sahilag22/COURSE-PROJECT-CE738A-/ppt-GROUP3_22103052,22103049.pptx

PROJECT -2
Hydrometry: CE-738A
SOIL MOISTURE
2022-2023
DEPARTMENT OF CIVIL ENGINEER
HYDRAULICS AND WATER RESOURCES ENGINEERING
Course Instructor: Presented by:
Dr. Shivam Tripathi Sahil Agrawal and Ranjan Kumar
Monday, November 14, 2022

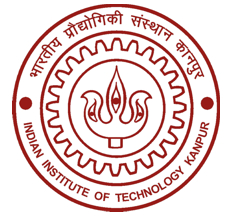
[picture p1: figure]
See the source image

## TABLE OF CONTENTS

1. INTRODUCTION
2. VARIOUS SENSOR TO MEASURE SM
3. LISTS OF COMPONENTS
4. CIRCUIT DIAGRAM
5. SEQUENCE OF PROCESSES
6. UNCERTAINTY ANALYSIS
7. LIMITATIONS
8. REFERENCES

## 1. INTRODUCTION

- Soil moisture represents the water content present in the soil
- It is a key variable in controlling the exchange of water and heat energy between the land surface and the atmosphere through transpiration and evaporation.
- Monitoring soil moisture helps to detect the health of the plant.
- Can be measured by direct and indirect methods.
- Direct methods includes: gravimetric and volumetric
- Indirect methods includes : the applications of electromagnetic or electrical properties calibrated to get soil moisture.
- We have used resistive soil moisture sensor which is calibrated with the direct method- volumetric moisture content.

## 2. VARIOUS SENSORS USED TO MEASURE SM

A) Resistive soil moisture sensor
- Measures the conductivity of the soil and describes water content.
B) Capacitive soil moisture sensor
- Measures the ions present in the soil.
C) Neutron probe
- Detects SM in its Sphere of influence
D) Electromagnetic sensor (
E) Tensiometers
F) GNSS based SM sensor
IN OUR PROJECT WE HAVE USED RESISTIVE SOIL MOISTURE SENSOR.

## Resistive soil moisture sensor

- The sensor consists of two probes which are used to measure the volumetric content of water.
- The two probes allow the DC current to pass through the soil and then it gets the resistance value to measure the moisture value.
- Soil moisture varies linearly with the resistance value
- Corrosion occurs as there is a DC current flowing which causes electrolysis of the sensors decreasing its efficiency.
- Resistive soil moisture sensor can give faulty values if some fertilizers were added to the soil which increases its conductivity without much water present in it.

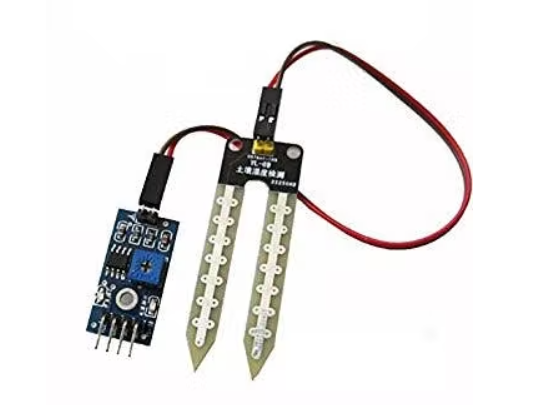
[picture p2: figure]

## 3. LIST OF COMPONENTS

- ARDUINO UNO
- ESP8266 WIFI MODULE
- HW-080 RESITIVE SM SENSOR
- DS1307 RTC I2C MODULE
- SD CARD MODULE
- DHT22 SENSOR

## 4. CIRCUIT DIAGRAM

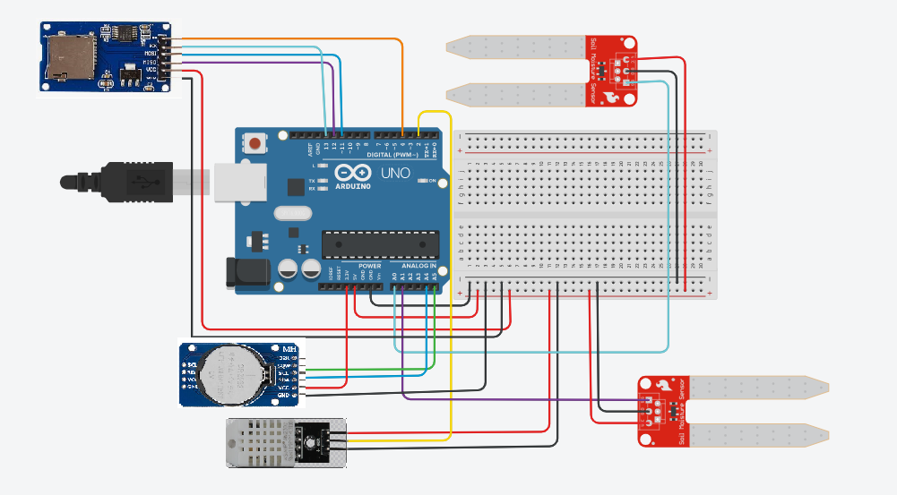
[picture p3: figure]

Resistive soil moisture sensor

Sd card module

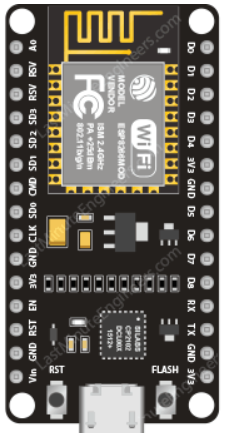
[picture p4: figure]

ESP8266 WIFI MODULE

RTC

DHT22

Resistive soil moisture sensor

## 5. SEQUENCE OF PROCECSS

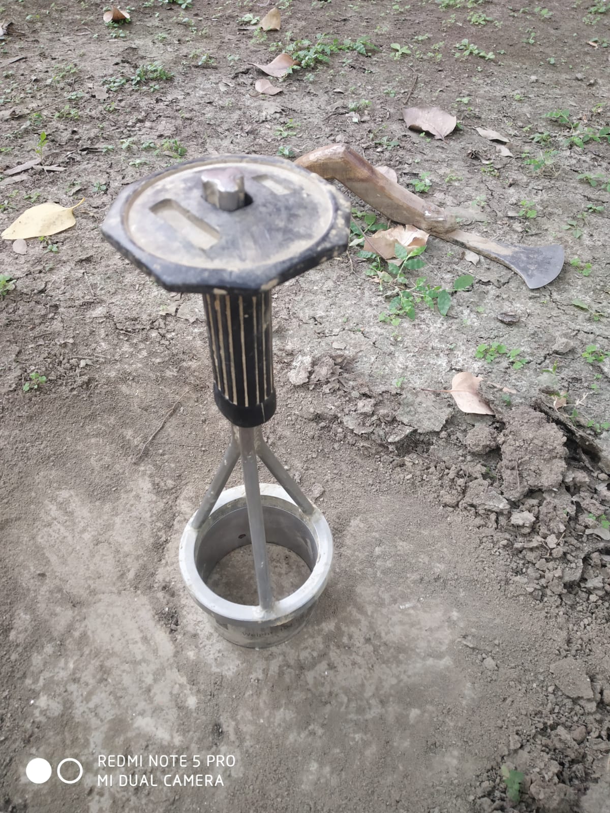
[picture p5: figure]

Calibration includes:
- Find bulk density of the soil
- Take sample of the soil and air dry it
- Make different containers with different water content in them.
- Use sensor and note the reading and then test a small sample size for gravimetric moisture content by oven drying the sample for 24hours at 105°C.
- Then calibrate the sensor with the volumetric moisture content.
- Find the uncertainty in calibration constants.

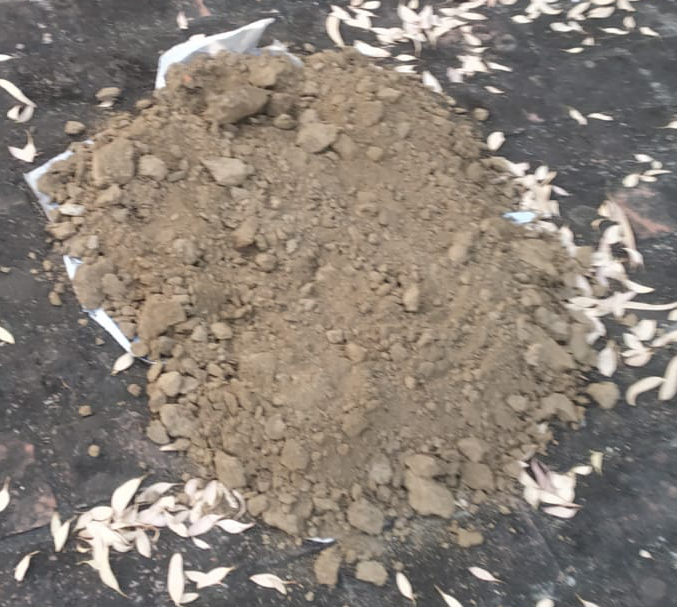
[picture p6: figure]
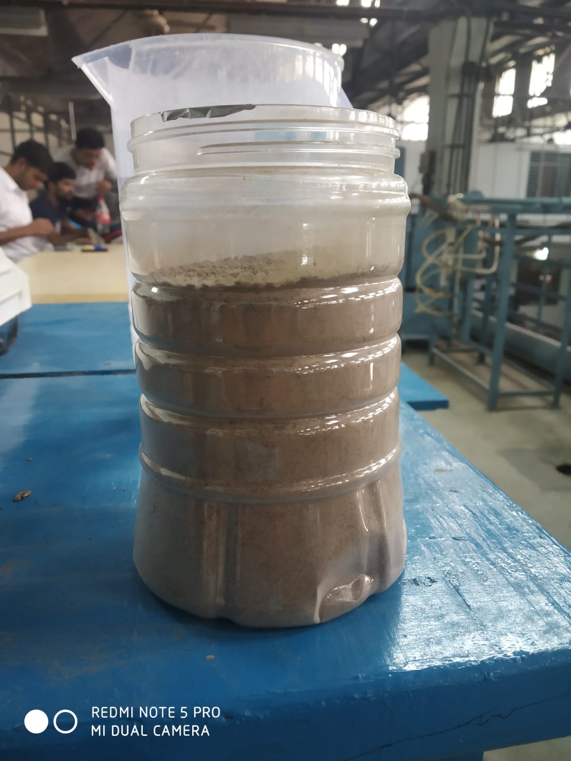
[picture p7: figure]
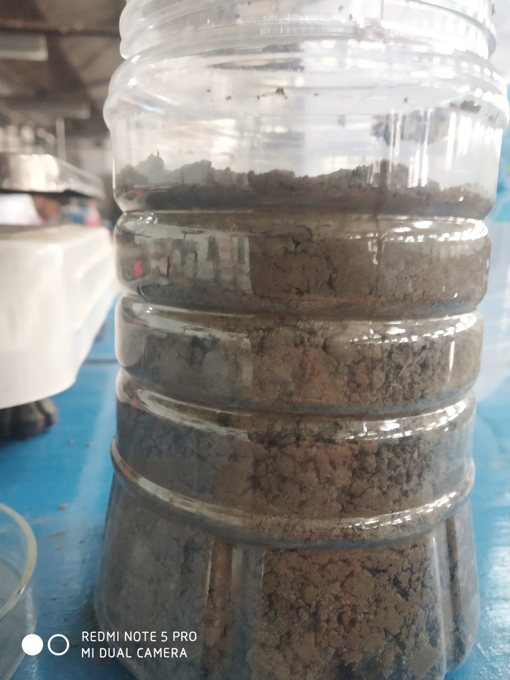
[picture p8: figure]
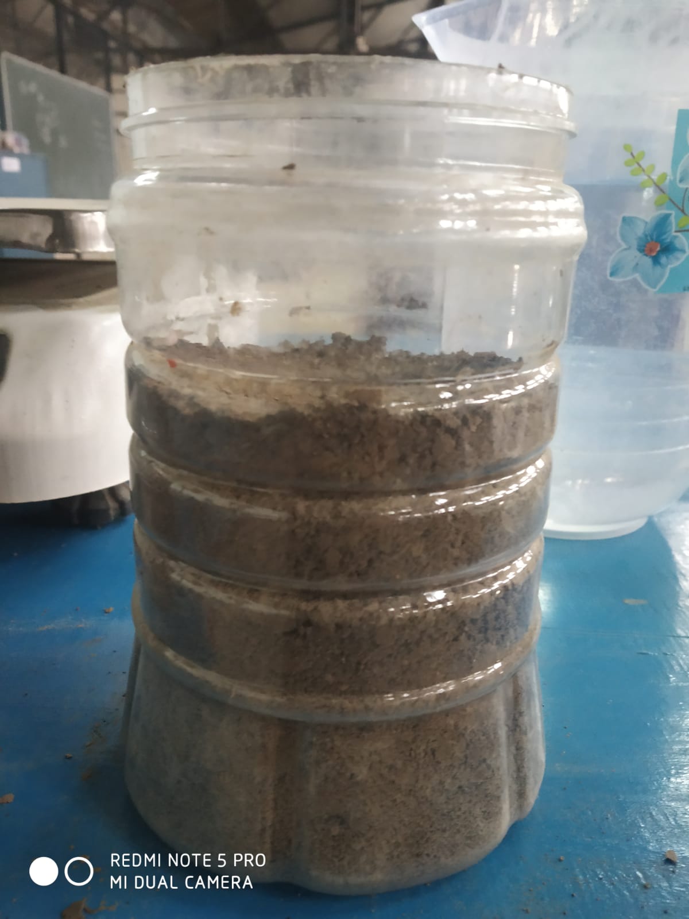
[picture p9: figure]
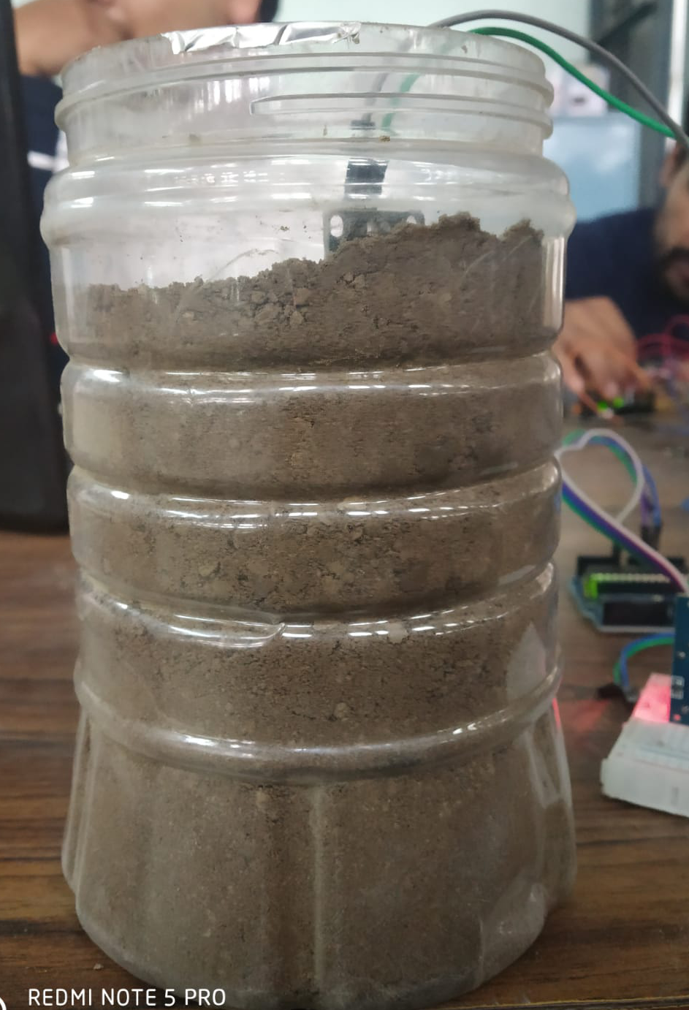
[picture p10: figure]
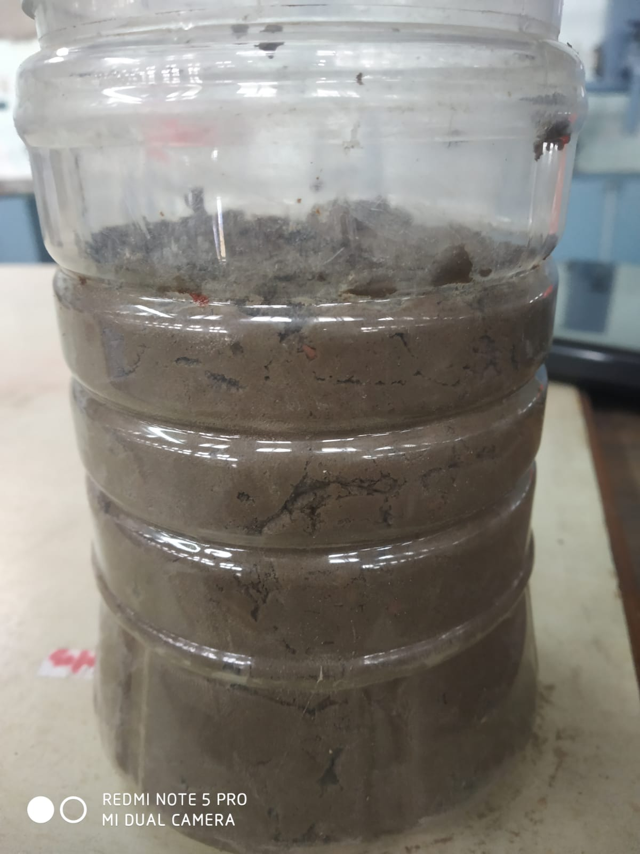
[picture p11: figure]
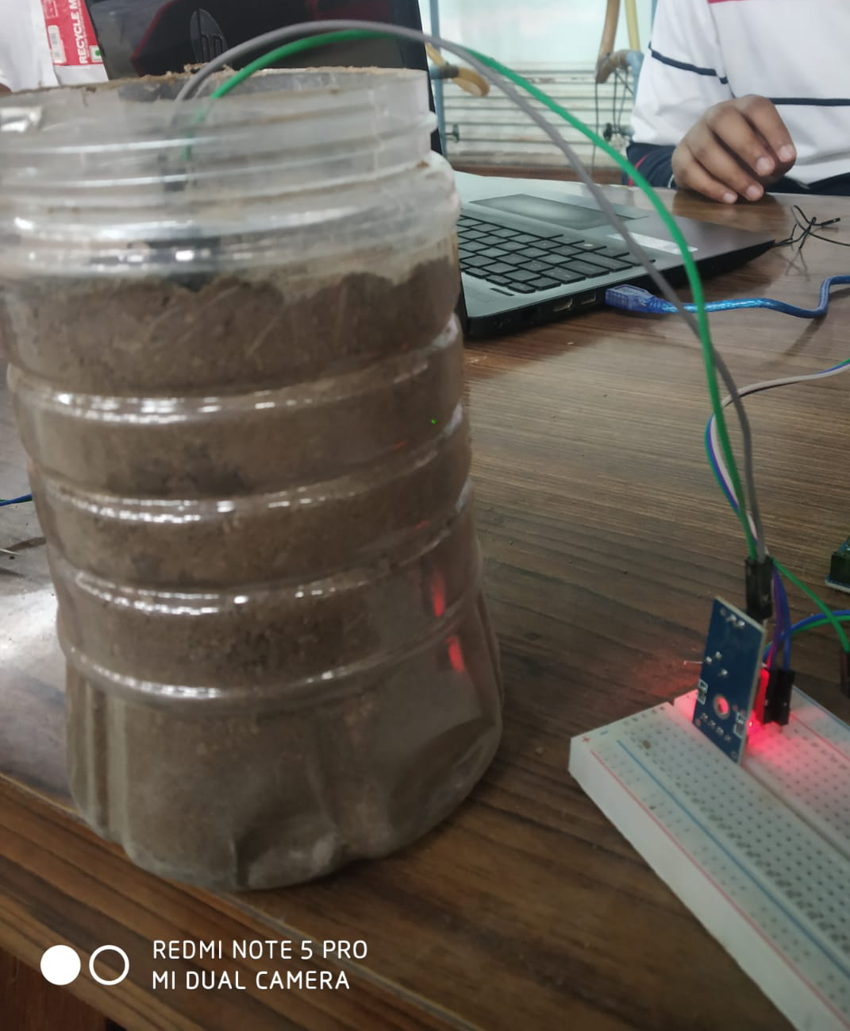
[picture p12: figure]
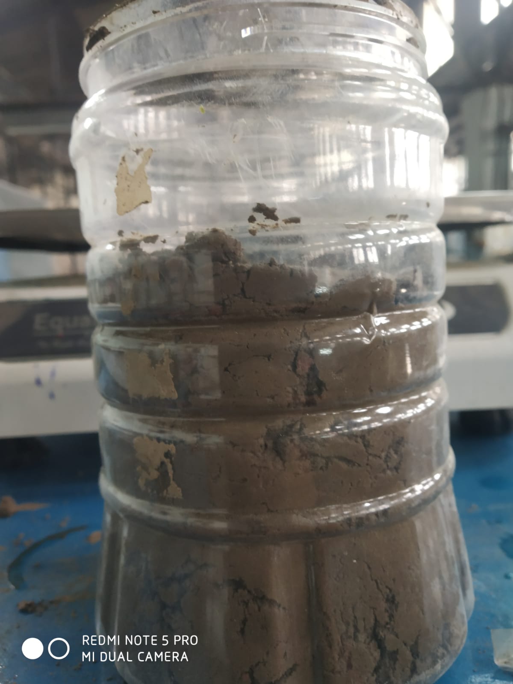
[picture p13: figure]
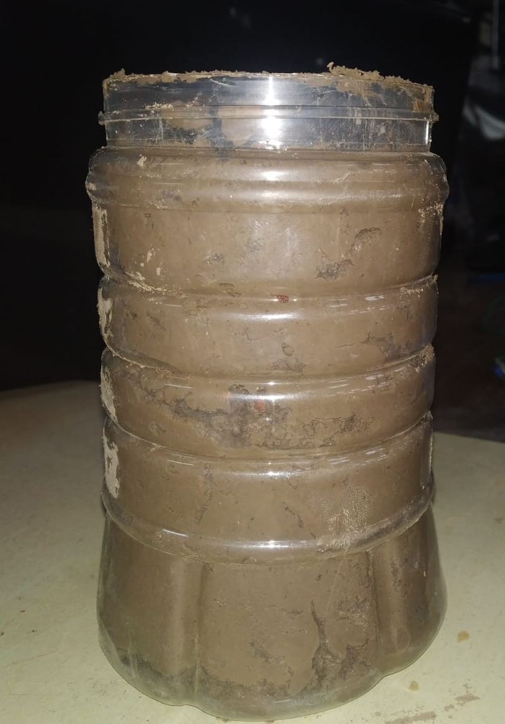
[picture p14: figure]

## Slide 9

Bulk density
(dry weight of soil)/(total volume of soil)
(dry weigℎt of soil)/(total volume of soil)
Gravimetric moisture content
(weight of water)/(total dry weight)
(weigℎt of water)/(total dry weigℎt)
Volumetric moisture content.
Bulk density*gmc
= (dry weight of soil)/(total volume)∗(weight of water)/(total dry weight)
= (weight of water)/(total volume of soil)∗100%
Bulk density*gmc
= (dry weigℎt of soil)/(total volume)∗(weigℎt of water )/(total dry weigℎt)
= (weigℎt of water)/(total volume of soil)∗100%

## Slide 10

- After the calibration
- Setup the circuit to measure the soil moisture in a plant
- Take sensor reading as the average of 10 continuous reading and consider the uncertainty associated
- With all the uncertainty , find uncertainty in the final VMC.
- Save the data in SD card, server, display on thingsspeak, using python code store it in postgres.

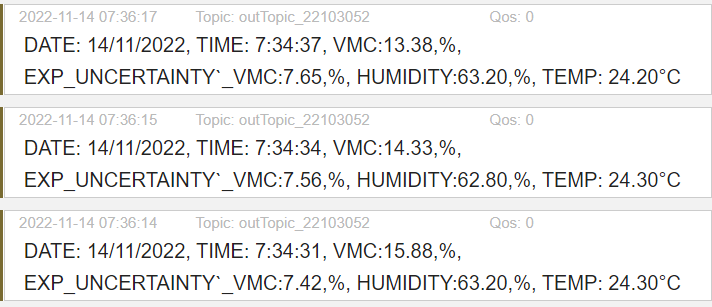
[picture p15: figure]
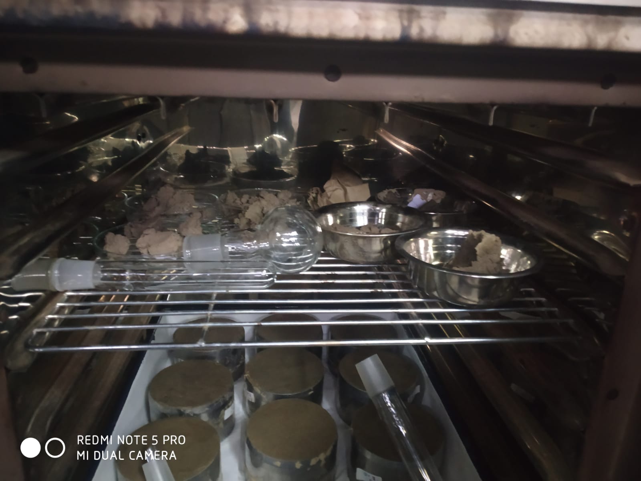
[picture p16: figure]
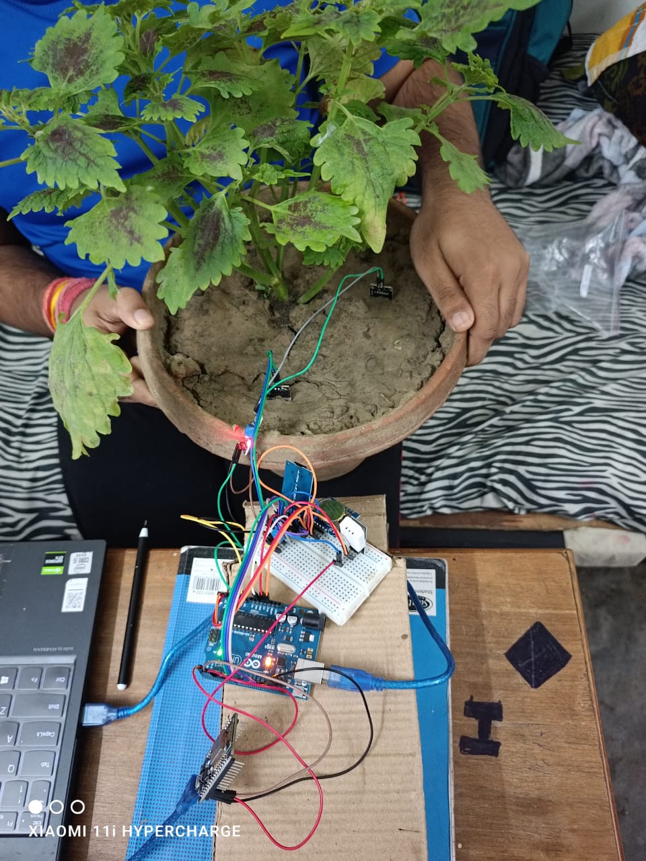
[picture p17: figure]

## Slide 11

6. UNCERTAINTY ANALYSIS

Bulk Density
2 samples
Repeatability
Gravimetric soil moisture content
9 samples
Repeatability
Volumetric moisture content
9 samples
= bulk density* gravimetric SMC

## Slide 12

Sensor data
Sensor 1
Sensor 2
10 Readings for each sample
9 samples
Corresponding 10 repeatability values
Uncertainty in sensor value
Standard error
Standard deviation/sqrt(n)

## Slide 13

Calibration of sensors
Sensor 1 eq.
Sensor 2 eq.
Select the region where R² close to 1

After leaving the value of sample 1 and 9 we get

## Slide 14

calibration
Modification of the data showed us the better linear regression model
It also implies that our soil moisture sensor gives better results for soil moisture in the range of sample 2 to sample 9
Why linear regression
If we go for polynomial/power regression line, we get best fit equation for all sample.
but the voltage measure varies linear with the moisture present in the soil.
What we get.
We got equation to calculate the volumetric moisture content with the sensor readings
Therefore from excel we get regression analysis, stating the uncertainty in slope and intercept value.

## Slide 15

Calibration equation
Vmc1 = m1*(SR1)+I1
Vmc2 = m2*(SR2)+I2
Uncertainty in m1,m2 and i1,i2 are known
SR1,SR2 are the average value of 10 values and uncertainty for SR will be the standard error.

With the known values we can calculate the uncertainty in the Vmc1 and Vmc2 by applying quadrature method for the known linear measurement model.

Final VMC = (Vmc1+Vmc2)/2
Combined Uncertainty of this model is calculated by quadrature method and a coverage factor is multiplied for the expanded uncertainty.

## 7. LIMITATION

- The soil moisture sensor used gives point based results which has lower influence volume.
- The resistive soil moisture sensor reading is related to the volumetric moisture content, therefore it requires bulk density in calibration which binds the sensor to give moisture content of soil with known bulk density.
- Sensor is highly prone to electrolysis and corrosion because of the salt present.
- No immediate change is observed in reading with change in moisture content, late response.
- Sensor is highly inaccurate.
- In uncertainty analysis all factors are not considered.

## 8. REFERENCES

- LECTURE SLIDES
- CLASS NOTES
- TINKERCAD
- https://forum.arduino.cc/

## THANK YOU
