sahilag22/COURSE-PROJECT-CE738A-/pcb design/soil_mositure_pcb.png

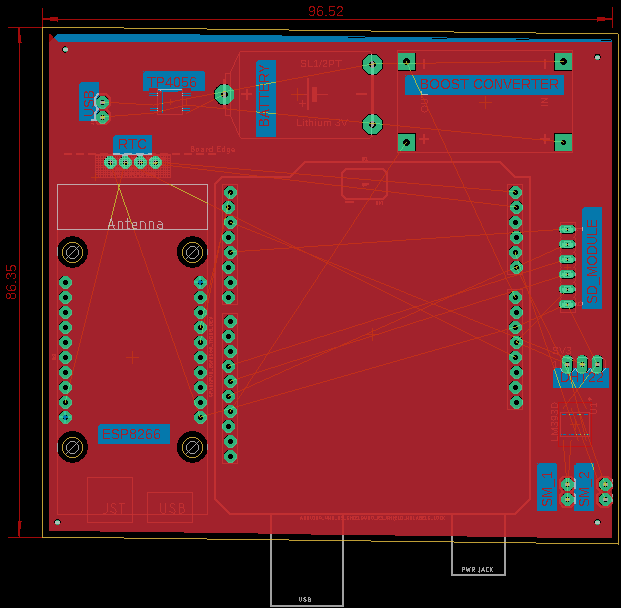
pcb design/soil_mositure_pcb.png
