sahilag22/COURSE-PROJECT-CE738A-/pcb design/SOIL.brd

## EAGLE design pcb design/SOIL.brd (2023-08-25)

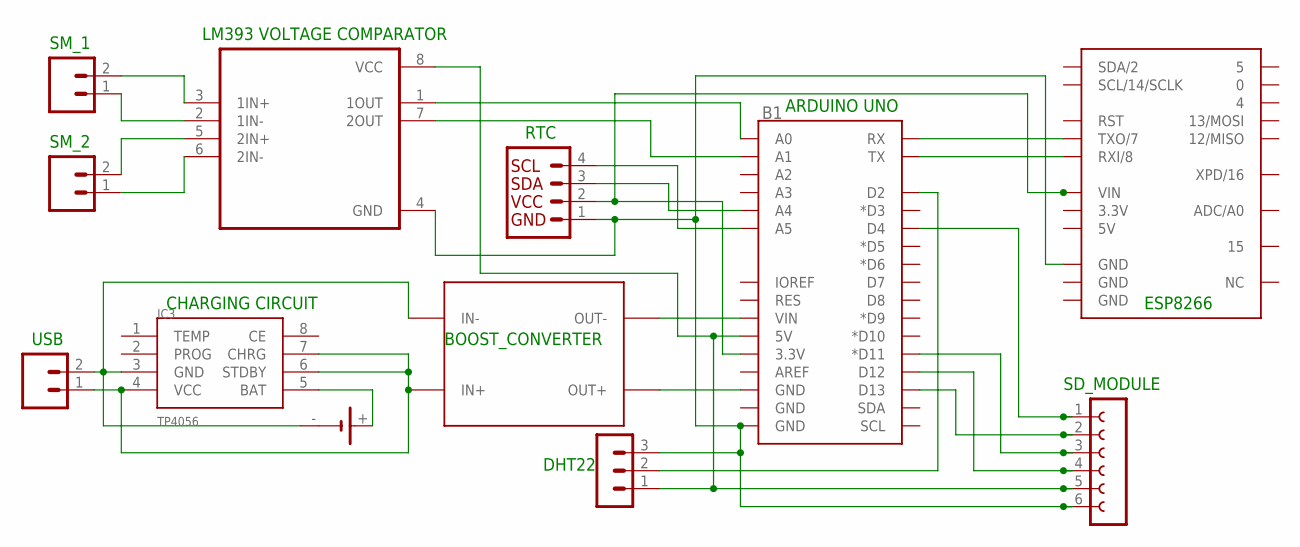
[picture p38: schematic SOIL.sch]

Parts:
B1: ARDUINO_UNO_R3_SHIELDUNO_R3_SHIELD_NOLABELS_LOCK; UNO_R3_SHIELD_NOLABELS_LOCK
B2: SPARKFUN_ESP8266_THING_DEV
G1: SL-150-1/2AA/PT
IC3: TP4056; SOP-8
J3, J5, J6: CONN_02; 1X02
J4: I2C_STANDARDUNITEST; 1X04_UNITEST
SV3: MA03-1
SV4: FE06-1; FE06
U1: LM393D; SOIC127P600X175-8N
U$1: DC-DC-STEP-UP-MT3608

Connections:
3.3V: B2.3.3V
5V: B2.5V
GND: B2.GND@2 (GND), B2.GND@3 (GND)
unnamed: B1.VIN, U$1.OUT-
unnamed: B1.GND@2 (GND), U$1.OUT+
unnamed: G1.-, IC3.3 (GND), J5.2, U$1.IN-
unnamed: IC3.4 (VCC), IC3.6 (STDBY), IC3.7 (CHRG), J5.1, U$1.IN+
unnamed: G1.+, IC3.5 (BAT)
unnamed: J6.2, U1.3 (1IN+)
unnamed: B1.D4, SV4.1
unnamed: B1.D13, SV4.2
unnamed: B1.D11 (*D11), SV4.3
unnamed: B1.D12, SV4.4
unnamed: B1.5V, SV3.1, SV4.5, U1.8 (VCC)
unnamed: B1.GND@0 (GND), B2.GND@1 (GND), J4.1, SV3.3, SV4.6, U1.4 (GND)
unnamed: B1.A5, J4.4
unnamed: B1.A4, J4.3
unnamed: B1.3.3V, B2.VIN, J4.2
unnamed: B1.RX, B2.TX (TXO/7)
unnamed: B1.TX, B2.RX (RXI/8)
unnamed: B1.D2, SV3.2
unnamed: J6.1, U1.2 (1IN-)
unnamed: B1.A1, U1.7 (2OUT)
unnamed: B1.A0, U1.1 (1OUT)
unnamed: J3.2, U1.5 (2IN+)
unnamed: J3.1, U1.6 (2IN-)

Notes on the sheet:
SM_1
SM_2
BOOST_CONVERTER
USB
LM393 VOLTAGE COMPARATOR
RTC
CHARGING CIRCUIT
ARDUINO UNO
DHT22
SD_MODULE
ESP8266

Board: 2 copper layers, 12 parts (0 on the bottom side), 24 nets, no tracks yet.
